blhuynh/BME354_FinalProject/README.md

BME354_FinalProject
===================

BME354 S2014
