blhuynh/BME354_FinalProject/BME354_FinalPresentation.pdf

# Pulse Oximetry

# Michael Rees, Brian Huynh Bme 354 - Palmeri

# Functional Block Diagram - Hardware

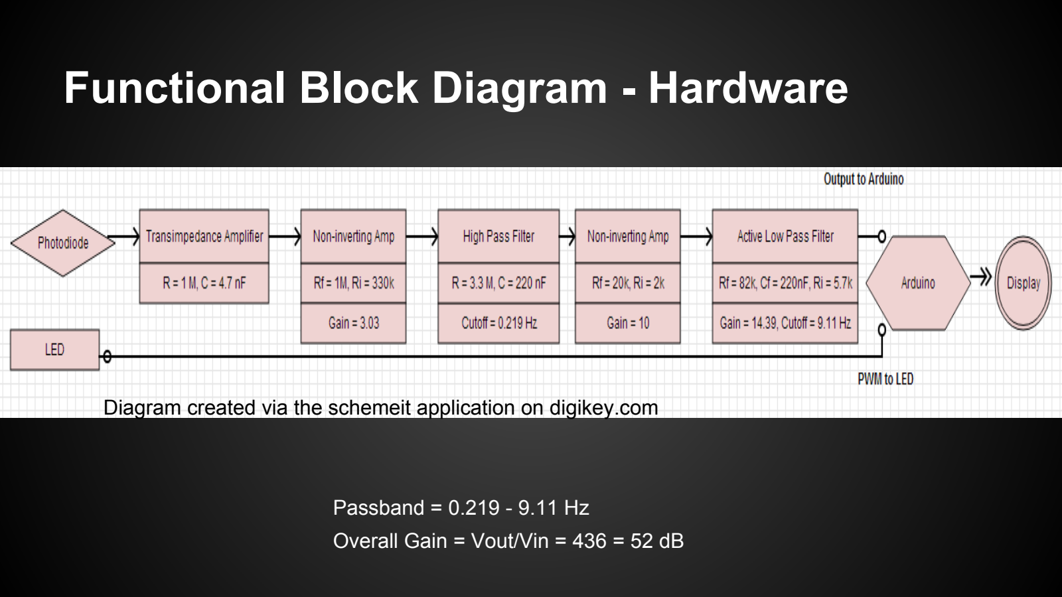
[picture p1: page 2]

Passband = 0.219 - 9.11 Hz
Overall Gain = Vout/Vin = 436 = 52 dB

Diagram created via the schemeit application on digikey.com

# Circuit Diagram

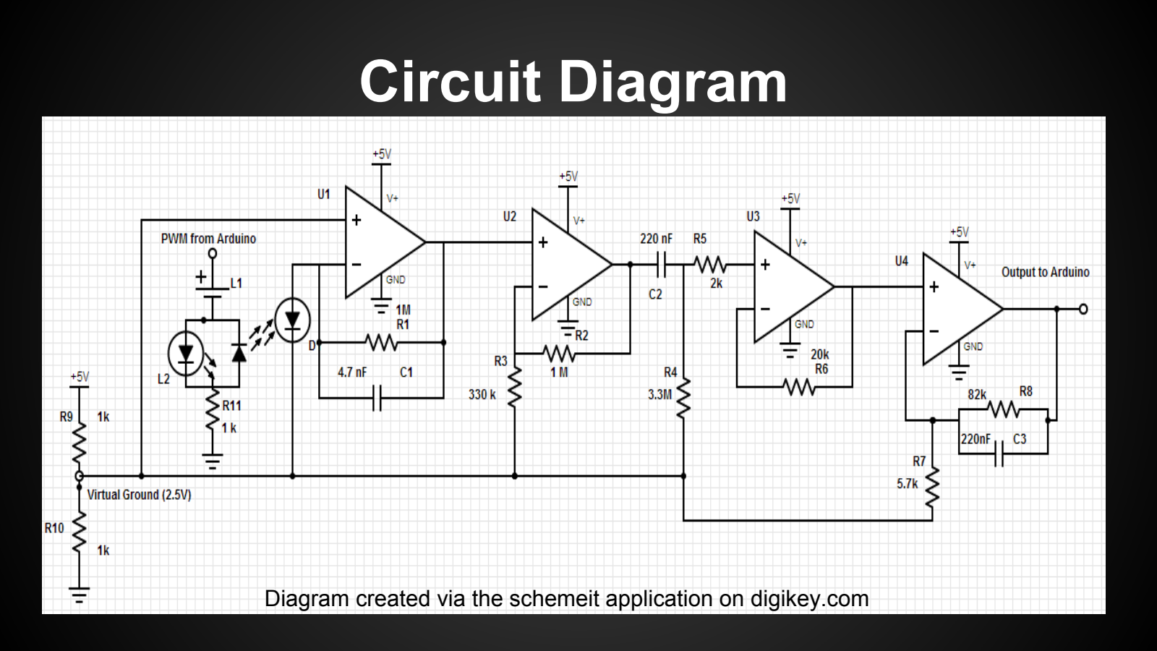
[picture p2: page 3]

Diagram created via the schemeit application on digikey.com

# Sample Signal

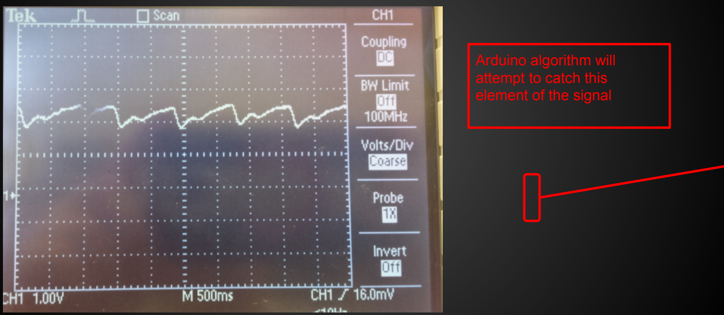
[picture p3: figure]
Arduino algorithm will attempt to catch this element of the signal

# Coding Structure

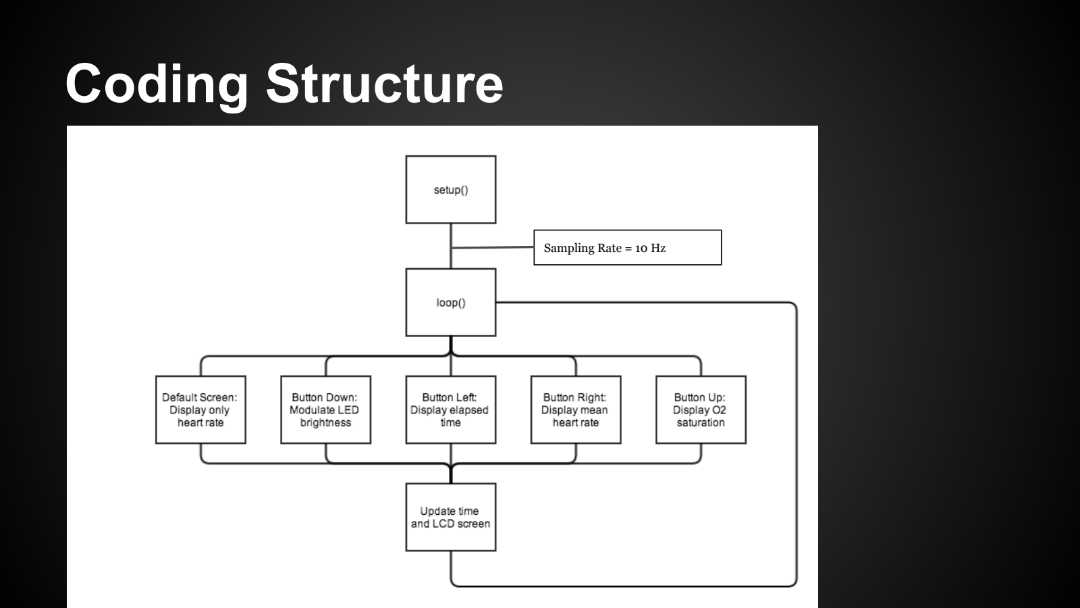
[picture p4: page 5]

Sampling Rate = 10 Hz
